futurelink/grbl-plus/(list of files, drawings)

Other design files:
hardware/stm32-grbl.dsn
