futurelink/grbl-plus/hardware/stm32-grbl.kicad_pcb

## KiCad design hardware/stm32-grbl.kicad_pcb (2022-02-22)

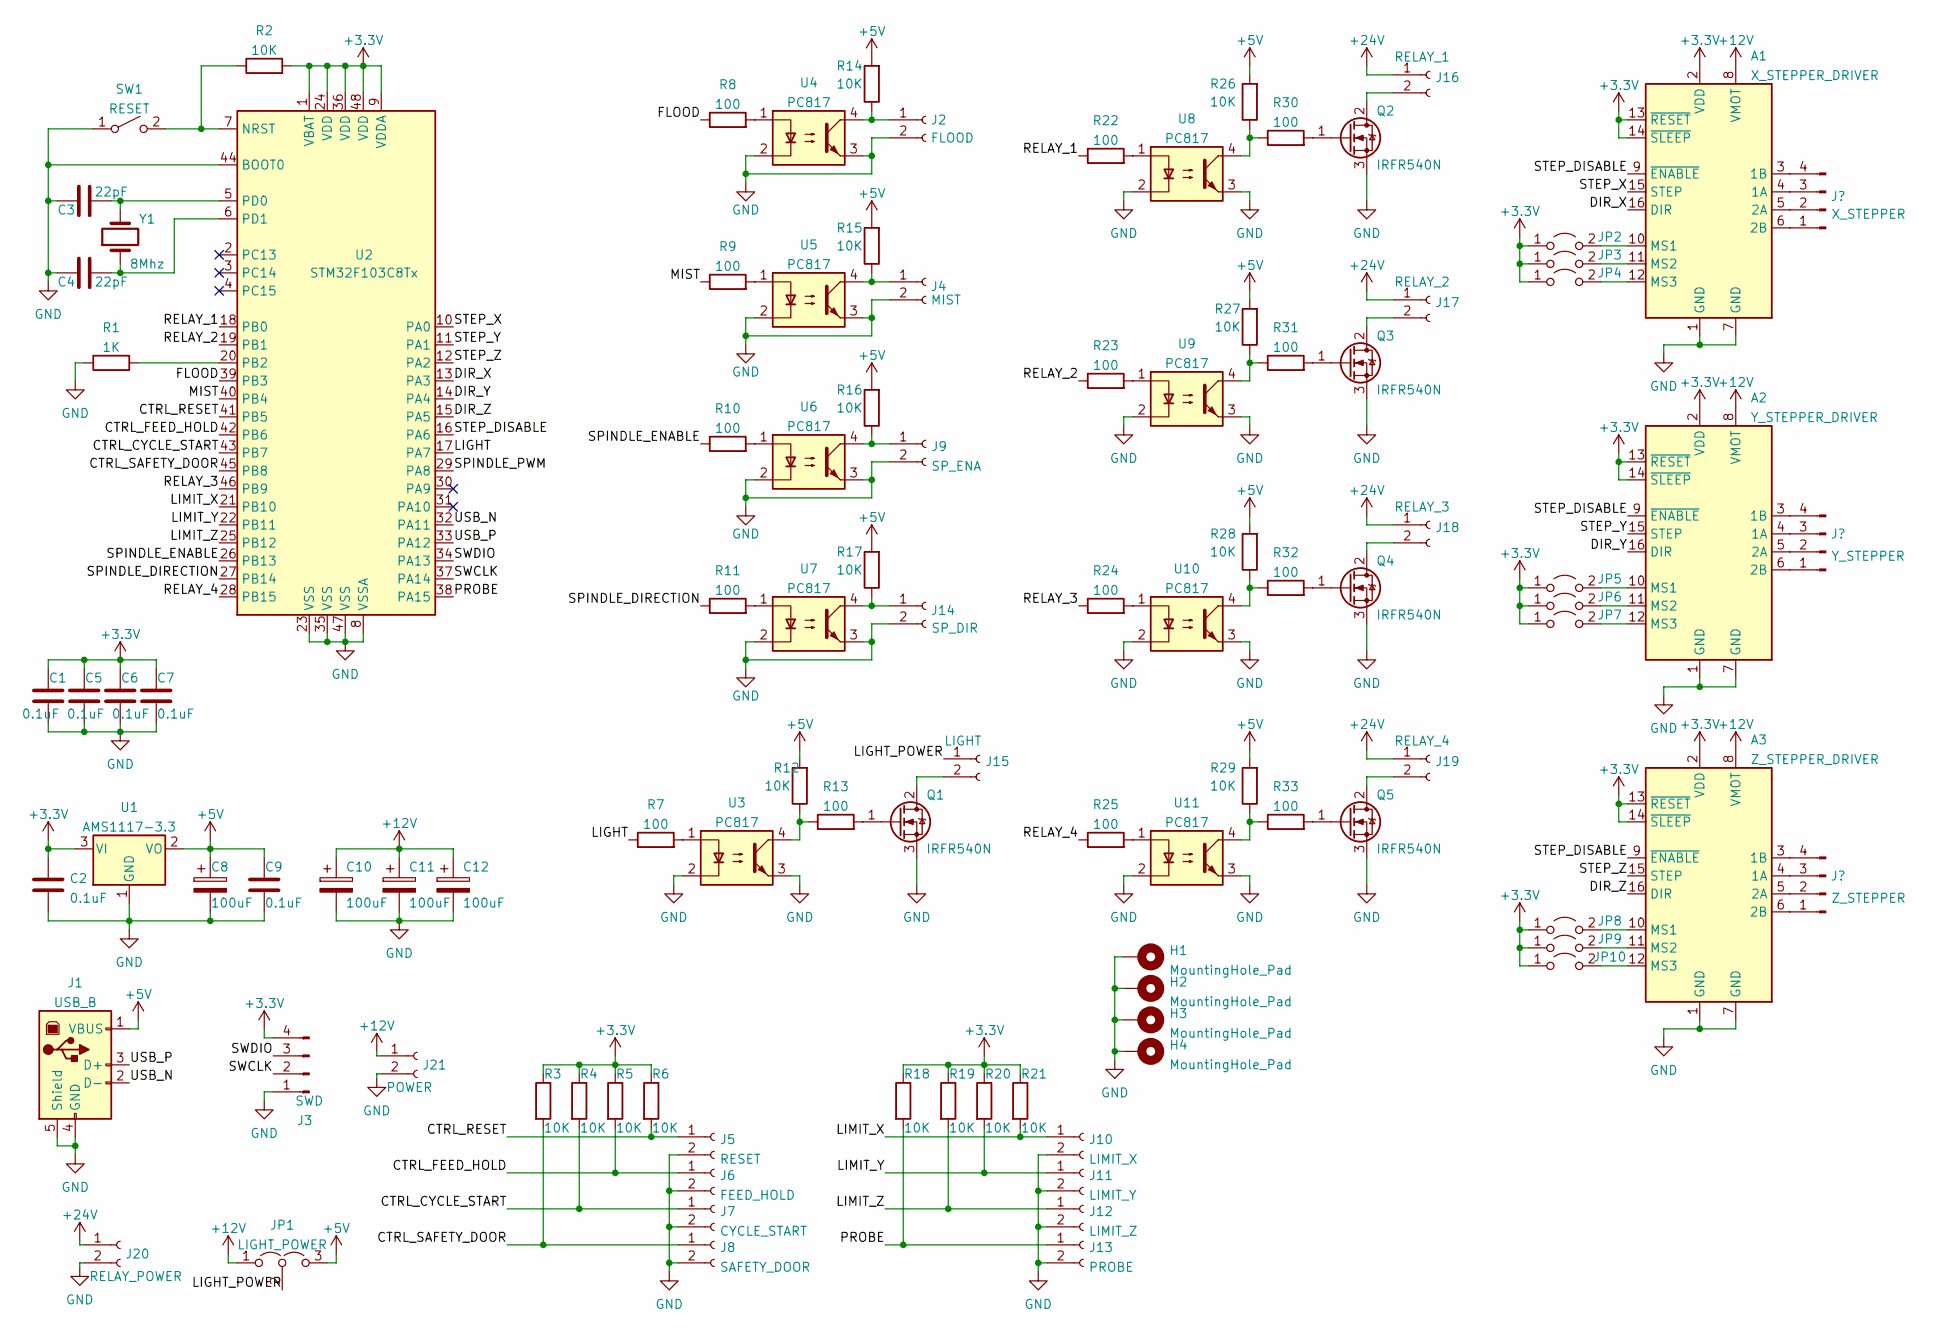
[picture p1: schematic stm32-grbl.kicad_sch]

Parts:
A1: X_STEPPER_DRIVER; Pololu_Breakout-16_15.2x20.3mm
A2: Y_STEPPER_DRIVER; Pololu_Breakout-16_15.2x20.3mm
A3: Z_STEPPER_DRIVER; Pololu_Breakout-16_15.2x20.3mm
C1, C2, C5, C6, C7, C9: 0.1uF; C_0805_2012Metric
C3, C4: 22pF; C_0805_2012Metric
C8: 100uF; CP_Elec_8x10
C10, C11, C12: 100uF; CP_Elec_6.3x7.7
H1, H2, H3, H4: MountingHole_Pad; MountingHole_3.2mm_M3_Pad
J1: USB_B; USB_B_OST_USB-B1HSxx_Horizontal
J2: FLOOD; JST_EH_B2B-EH-A_1x02_P2.50mm_Vertical
J3: SWD; PinHeader_1x04_P2.54mm_Vertical
J4: MIST; JST_EH_B2B-EH-A_1x02_P2.50mm_Vertical
J5: RESET; JST_EH_B2B-EH-A_1x02_P2.50mm_Vertical
J6: FEED_HOLD; JST_EH_B2B-EH-A_1x02_P2.50mm_Vertical
J7: CYCLE_START; JST_EH_B2B-EH-A_1x02_P2.50mm_Vertical
J8: SAFETY_DOOR; JST_EH_B2B-EH-A_1x02_P2.50mm_Vertical
J9: SP_ENA; JST_EH_B2B-EH-A_1x02_P2.50mm_Vertical
J10: LIMIT_X; JST_EH_B2B-EH-A_1x02_P2.50mm_Vertical
J11: LIMIT_Y; JST_EH_B2B-EH-A_1x02_P2.50mm_Vertical
J12: LIMIT_Z; JST_EH_B2B-EH-A_1x02_P2.50mm_Vertical
J13: PROBE; JST_EH_B2B-EH-A_1x02_P2.50mm_Vertical
J14: SP_DIR; JST_EH_B2B-EH-A_1x02_P2.50mm_Vertical
J15: LIGHT; JST_EH_B2B-EH-A_1x02_P2.50mm_Vertical
J16: RELAY_1; TerminalBlock_bornier-2_P5.08mm
J17: RELAY_2; TerminalBlock_bornier-2_P5.08mm
J18: RELAY_3; TerminalBlock_bornier-2_P5.08mm
J19: RELAY_4; TerminalBlock_bornier-2_P5.08mm
J20: RELAY_POWER; TerminalBlock_bornier-2_P5.08mm
J21: POWER; TerminalBlock_bornier-2_P5.08mm
JP1: LIGHT_POWER; PinHeader_1x03_P2.54mm_Vertical
JP2, JP3, JP4, JP5, JP6, JP7, JP8, JP9, JP10: Jumper_2_Open; PinHeader_1x02_P2.54mm_Vertical
Q1, Q2, Q3, Q4, Q5: IRFR540N; TO-252-2
R1: 1K; R_0805_2012Metric
R2, R3, R4, R5, R6, R12, R14, R15, R16, R17, R18, R19, R20, R21, R26, R27, R28, R29: 10K; R_0805_2012Metric
R7, R8, R9, R10, R11, R13, R22, R23, R24, R25, R30, R31, R32, R33: 100; R_0805_2012Metric
SW1: RESET; SW_Push_1P1T_NO_6x6mm_H9.5mm
U1: AMS1117-3.3; SOT-223-3_TabPin2
U2: STM32F103C8Tx; LQFP-48_7x7mm_P0.5mm
U3, U4, U5, U6, U7, U8, U9, U10, U11: PC817; SMDIP-4_W7.62mm
Y1: 8Mhz; Crystal_SMD_5032-2Pin_5.0x3.2mm

Connections:
+3V3: A1.2 (VDD), A1.13 (~RESET), A1.14 (~SLEEP), A2.2 (VDD), A2.13 (~RESET), A2.14 (~SLEEP), A3.2 (VDD), A3.13 (~RESET), A3.14 (~SLEEP), C1.1, C2.1, C5.1, C6.1, C7.1, J3.4, JP2.1 (A), JP3.1 (A), JP4.1 (A), JP5.1 (A), JP6.1 (A), JP7.1 (A), JP8.1 (A), JP9.1 (A), JP10.1 (A), R2.2, R3.1, R4.1, R5.1, R6.1, R18.1, R19.1, R20.1, R21.1, U1.3 (VI), U2.1 (VBAT), U2.9 (VDDA), U2.24 (VDD), U2.36 (VDD), U2.48 (VDD)
+5V: C8.1, C9.1, J1.1 (VBUS), JP1.3 (B), R12.2, R14.2, R15.2, R16.2, R17.2, R26.2, R27.2, R28.2, R29.2, U1.2 (VO)
+12V: A1.8 (VMOT), A2.8 (VMOT), A3.8 (VMOT), C10.1, C11.1, C12.1, J21.1, JP1.1 (A)
+24V: J16.1, J17.1, J18.1, J19.1, J20.1
/CTRL_CYCLE_START: J7.1, R4.2, U2.43 (PB7)
/CTRL_FEED_HOLD: J6.1, R5.2, U2.42 (PB6)
/CTRL_RESET: J5.1, R6.2, U2.41 (PB5)
/CTRL_SAFETY_DOOR: J8.1, R3.2, U2.45 (PB8)
/DIR_X: A1.16 (DIR), U2.13 (PA3)
/DIR_Y: A2.16 (DIR), U2.14 (PA4)
/DIR_Z: A3.16 (DIR), U2.15 (PA5)
/FLOOD: R8.1, U2.39 (PB3)
/LIGHT: R7.1, U2.17 (PA7)
/LIGHT_POWER: J15.1, JP1.2 (C)
/LIMIT_X: J10.1, R21.2, U2.21 (PB10)
/LIMIT_Y: J11.1, R20.2, U2.22 (PB11)
/LIMIT_Z: J12.1, R19.2, U2.25 (PB12)
/MIST: R9.1, U2.40 (PB4)
/PROBE: J13.1, R18.2, U2.38 (PA15)
/RELAY_1: R22.1, U2.18 (PB0)
/RELAY_2: R23.1, U2.19 (PB1)
/RELAY_3: R24.1, U2.46 (PB9)
/RELAY_4: R25.1, U2.28 (PB15)
/SPINDLE_DIRECTION: R11.1, U2.27 (PB14)
/SPINDLE_ENABLE: R10.1, U2.26 (PB13)
/SPINDLE_PWM: U2.29 (PA8)
/STEP_DISABLE: A1.9 (~ENABLE), A2.9 (~ENABLE), A3.9 (~ENABLE), U2.16 (PA6)
/STEP_X: A1.15 (STEP), U2.10 (PA0)
/STEP_Y: A2.15 (STEP), U2.11 (PA1)
/STEP_Z: A3.15 (STEP), U2.12 (PA2)
/SWCLK: J3.2, U2.37 (PA14)
/SWDIO: J3.3, U2.34 (PA13)
/USB_N: J1.2 (D-), U2.32 (PA11)
/USB_P: J1.3 (D+), U2.33 (PA12)
GND: A1.1 (GND), A1.7 (GND), A2.1 (GND), A2.7 (GND), A3.1 (GND), A3.7 (GND), C1.2, C2.2, C3.1, C4.1, C5.2, C6.2, C7.2, C8.2, C9.2, C10.2, C11.2, C12.2, H1.1, H2.1, H3.1, H4.1, J1.4 (GND), J1.5 (Shield), J2.2, J3.1, J4.2, J5.2, J6.2, J7.2, J8.2, J9.2, J10.2, J11.2, J12.2, J13.2, J14.2, J20.2, J21.2, Q1.3 (S), Q2.3 (S), Q3.3 (S), Q4.3 (S), Q5.3 (S), R1.1, SW1.1 (A), U1.1 (GND), U2.8 (VSSA), U2.23 (VSS), U2.35 (VSS), U2.44 (BOOT0), U2.47 (VSS), U3.2, U3.3, U4.2, U4.3, U5.2, U5.3, U6.2, U6.3, U7.2, U7.3, U8.2, U8.3, U9.2, U9.3, U10.2, U10.3, U11.2, U11.3
unnamed 35: A1.3 (1B); also elsewhere on the board
unnamed 36: A1.4 (1A); also elsewhere on the board
unnamed 37: A1.5 (2A); also elsewhere on the board
unnamed 38: A1.6 (2B); also elsewhere on the board
unnamed: A1.10 (MS1), JP2.2 (B)
unnamed: A1.11 (MS2), JP3.2 (B)
unnamed: A1.12 (MS3), JP4.2 (B)
unnamed 42: A2.3 (1B); also elsewhere on the board
unnamed 43: A2.4 (1A); also elsewhere on the board
unnamed 44: A2.5 (2A); also elsewhere on the board
unnamed 45: A2.6 (2B); also elsewhere on the board
unnamed: A2.10 (MS1), JP5.2 (B)
unnamed: A2.11 (MS2), JP6.2 (B)
unnamed: A2.12 (MS3), JP7.2 (B)
unnamed 49: A3.3 (1B); also elsewhere on the board
unnamed 50: A3.4 (1A); also elsewhere on the board
unnamed 51: A3.5 (2A); also elsewhere on the board
unnamed 52: A3.6 (2B); also elsewhere on the board
unnamed: A3.10 (MS1), JP8.2 (B)
unnamed: A3.11 (MS2), JP9.2 (B)
unnamed: A3.12 (MS3), JP10.2 (B)
unnamed: C3.2, U2.5 (PD0), Y1.2
unnamed: C4.2, U2.6 (PD1), Y1.1
unnamed: Q1.1 (G), R13.2
unnamed: J15.2, Q1.2 (D)
unnamed: Q2.1 (G), R30.2
unnamed: J16.2, Q2.2 (D)
unnamed: Q3.1 (G), R31.2
unnamed: J17.2, Q3.2 (D)
unnamed: Q4.1 (G), R32.2
unnamed: J18.2, Q4.2 (D)
unnamed: Q5.1 (G), R33.2
unnamed: J19.2, Q5.2 (D)
unnamed: R1.2, U2.20 (PB2)
unnamed: R2.1, SW1.2 (B), U2.7 (NRST)
unnamed: R7.2, U3.1
unnamed: R8.2, U4.1
unnamed: R9.2, U5.1
unnamed: R10.2, U6.1
unnamed: R11.2, U7.1
unnamed: R12.1, R13.1, U3.4
unnamed: J2.1, R14.1, U4.4
unnamed: J4.1, R15.1, U5.4
unnamed: J9.1, R16.1, U6.4
unnamed: J14.1, R17.1, U7.4
unnamed: R22.2, U8.1
unnamed: R23.2, U9.1
unnamed: R24.2, U10.1
unnamed: R25.2, U11.1
unnamed: R26.1, R30.1, U8.4
unnamed: R27.1, R31.1, U9.4
unnamed: R28.1, R32.1, U10.4
unnamed: R29.1, R33.1, U11.4

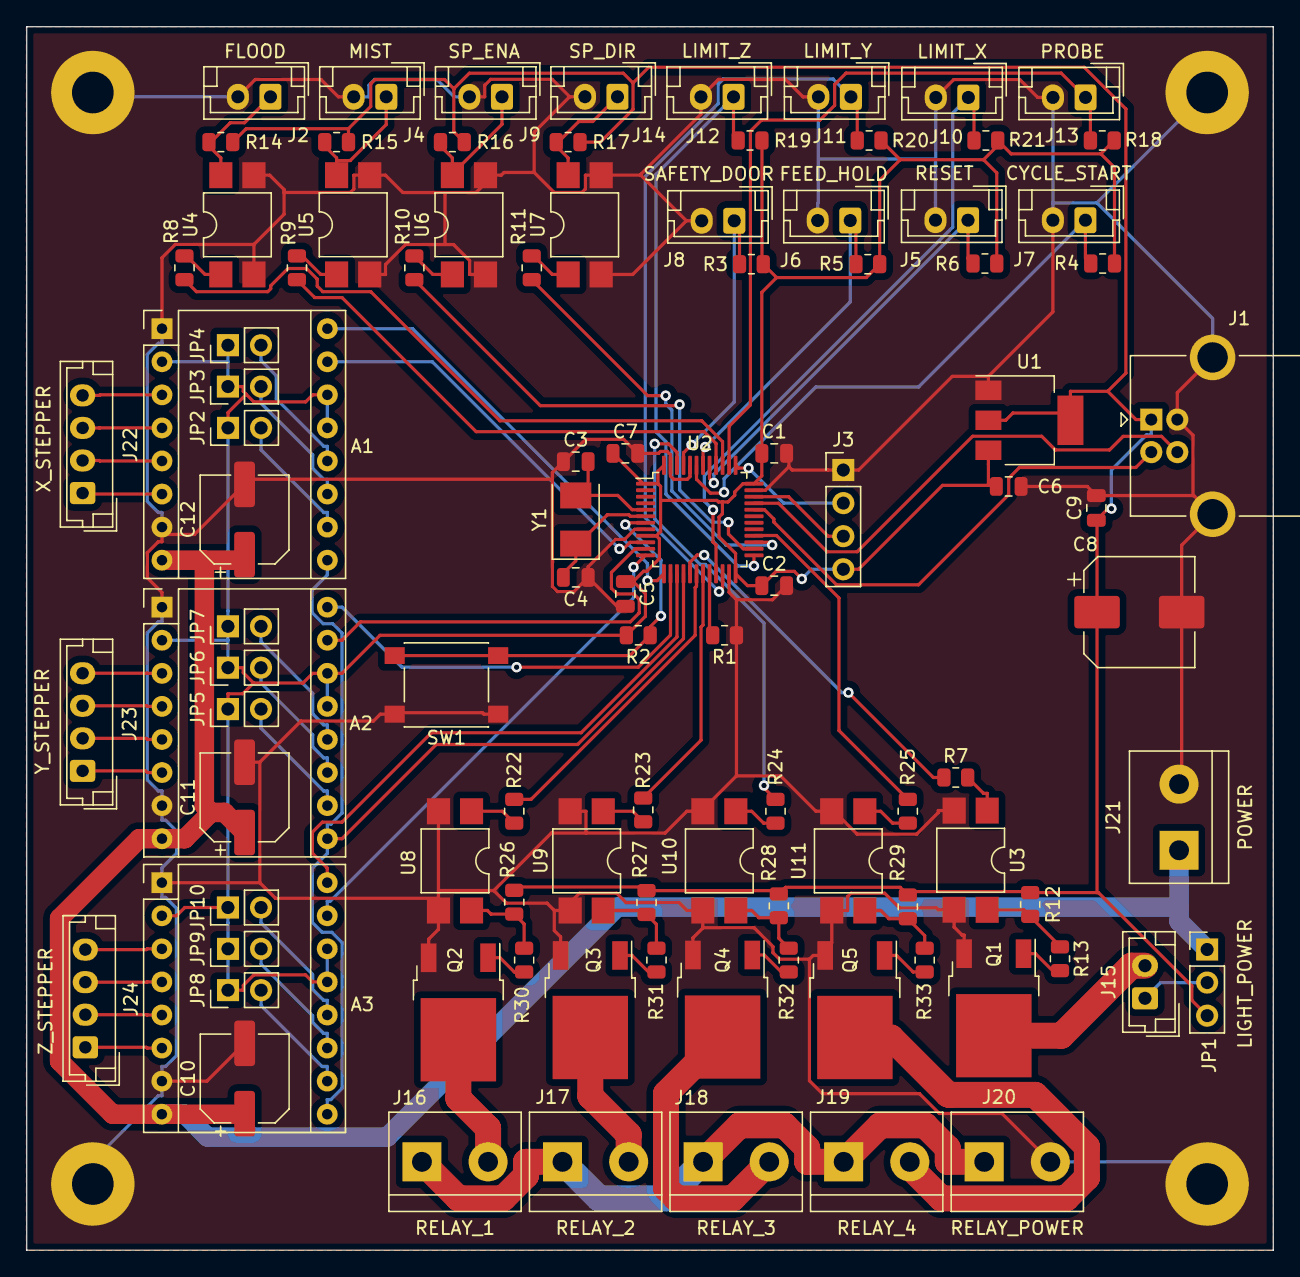
[picture p2: board stm32-grbl.kicad_pcb from above]

Board: 2 copper layers, 95.7 x 94.0 mm, 104 parts (0 on the bottom side), 87 nets.

Other parts of the board:
J22: X_STEPPER; JST_EH_B4B-EH-A_1x04_P2.50mm_Vertical
J23: Y_STEPPER; JST_EH_B4B-EH-A_1x04_P2.50mm_Vertical
J24: Z_STEPPER; JST_EH_B4B-EH-A_1x04_P2.50mm_Vertical

Their connections:
unnamed 35: J22.4; also elsewhere on the board
unnamed 36: J22.3; also elsewhere on the board
unnamed 37: J22.2; also elsewhere on the board
unnamed 38: J22.1; also elsewhere on the board
unnamed 42: J23.4; also elsewhere on the board
unnamed 43: J23.3; also elsewhere on the board
unnamed 44: J23.2; also elsewhere on the board
unnamed 45: J23.1; also elsewhere on the board
unnamed 49: J24.4; also elsewhere on the board
unnamed 50: J24.3; also elsewhere on the board
unnamed 51: J24.2; also elsewhere on the board
unnamed 52: J24.1; also elsewhere on the board
