futurelink/grbl-plus/(commit log)

2022-02-20 Partially made classes
    [defaults.h]
2022-02-20 Spindle made as class
2022-02-20 Probe made as a class
2022-02-21 Some work with steppers.
2022-02-21 moved headers
    [config.h, cpu_map.h, defaults.h]
2022-02-21 Some tidy up
    [config.h]
2022-02-21 Moved system props to GRBLSystem class
    [config.h]
2022-02-21 Rest of system props moved to GRBLSystem
2022-02-21 Removed printPgmString
2022-02-22 Hardware implementation
    [cpu_map.h, stm32-grbl.dsn, stm32-grbl.kicad_pcb, stm32-grbl.kicad_sch]
2022-02-22 HW update
    [stm32-grbl.kicad_sch]
