futurelink/grbl-plus/(notices)

Notices in the files:
app/include/grbl/defaults.h:
Grbl is free software: you can redistribute it and/or modify
it under the terms of the GNU General Public License as published by
the Free Software Foundation, either version 3 of the License, or
(at your option) any later version.
app/include/grbl/config.h:
Copyright (c) 2009-2011 Simen Svale Skogsrud
